danyw/PAR-Spectrometer/assets/Spectral response.xlsx

Sheet: Sheet1
 |  |  |  |  | SPECTRAL RESPONSE CORRECTION |  |  |  | CALIBRATION COEFFICIENTS
Wavelength [nm] | Typical | Actual | Normalized
340 | 35511300000000000 | 44540600000000000 | 646.57 |  |  |  | A0+B1_*pix+B2_*POWER(pix,2)+B3_*POWER(pix,3)+B4_*POWER(pix,4)+B5_*POWER(pix,5)
400 | 64586500000000000 | 63759400000000000 | 979.09
450 | 59557700000000000 | 64968200000000000 | 1000.00 |  |  |  |  |  |  |  |  |  |  | Pix | Waw. | Semsitivity | Normalized | Factor | Pix | Waw. | Semsitivity | Normalized | Factor | Pix | Waw. | Semsitivity | Normalized | Factor | Pix | Waw. | Semsitivity | Normalized | Factor | Pix | W.length | Semsitivity | Normalized | Factor | Pix | Waw. | Semsitivity | Normalized | Factor
500 | 57024200000000000 | 47367700000000000 | 695.48 |  |  |  |  |  |  |  |  |  |  | 1 | 309.6 | 45106555351522816 | 656.36 | 1.52 | 51 | 440.8 | 64745797393076808 | 996.15 | 1.00 | 101 | 561.4 | 43116223665321216 | 621.93 | 1.61 | 151 | 667.9 | 32894626288700832 | 445.08 | 2.25 | 201 | 758.5 | 19696558853128176 | 216.73 | 4.61 | 251 | 833.8 | 8983587113354304 | 31.38 | 31.87
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
