danyw/PAR-Spectrometer/Core/Src/main.c

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
/* Includes ------------------------------------------------------------------*/
#include "main.h"
#include "adc.h"
#include "dma.h"
#include "opamp.h"
#include "spi.h"
#include "tim.h"
#include "usart.h"
#include "usb_otg.h"
#include "gpio.h"

/* USER CODE BEGIN Includes */
#include "../../lvgl/lvgl.h"
#include "../../lvgl/hal_stm_lvgl/tft/tft.h"
#include "../../lvgl/hal_stm_lvgl/touch/touchpad.h"
#include "../../lvgl/examples/lv_examples.h"
#include "ui.h"
#include "ui_helpers.h"
/* USER CODE END Includes */

/* USER CODE BEGIN PD */
# define ADC_BUF_L 288
/* USER CODE END PD */


/* USER CODE BEGIN PV */
uint16_t adc_buf[ADC_BUF_L];
uint16_t adc_base = 1290;
bool continous = 1;
bool averaging = 1;
//bool overexposed = false;
bool auto_exposure = true;
uint16_t avg_counter = 0;
uint16_t avg = 50;
uint32_t exptime = 5000;
uint16_t peak_pixel = 0;




float wavelength_converted[288];
/* USER CODE END PV */

void SystemClock_Config(void);
/* USER CODE BEGIN PFP */
void measure (void);

extern void refresh_chart(void);
extern void refresh_chart_y(void);
extern void wavelength_convert(void);
extern void exposure_time (uint32_t st_us);
extern void adc_convert_first(void);
extern void adc_convert_second(void);
extern void averaging_buf(void);
/* USER CODE END PFP */

/**
  * @brief  The application entry point.
  * @retval int
  */
int main(void)
{
  /* MCU Configuration--------------------------------------------------------*/

  /* Reset of all peripherals, Initializes the Flash interface and the Systick. */
  HAL_Init();

  /* Configure the system clock */
  SystemClock_Config();

  /* Initialize all configured peripherals */
  MX_GPIO_Init();
  MX_USART3_UART_Init();
  MX_DMA_Init();
  MX_USB_OTG_HS_USB_Init();
  MX_SPI1_Init();
  MX_TIM3_Init();
  MX_SPI3_Init();
  MX_TIM2_Init();
  MX_TIM4_Init();
  MX_TIM15_Init();
  MX_ADC1_Init();
  MX_OPAMP1_Init();
  /* USER CODE BEGIN 2 */
  lv_init();
	tft_init();
	touchpad_init();
	HAL_Delay(20);

	HAL_OPAMP_SelfCalibrate(&hopamp1);
	HAL_OPAMP_Start(&hopamp1);

	HAL_ADCEx_Calibration_Start(&hadc1, ADC_CALIB_OFFSET, ADC_SINGLE_ENDED);
	HAL_ADCEx_Calibration_Start(&hadc1, ADC_CALIB_OFFSET_LINEARITY, ADC_SINGLE_ENDED);

	wavelength_convert();


	ui_init();

	HAL_TIM_Base_Start_IT(&htim3);
	HAL_TIM_Base_Start(&htim15);



	HAL_Delay(20);
	HAL_ADC_Start_DMA(&hadc1, (uint32_t*)adc_buf, ADC_BUF_L);



  /* USER CODE END 2 */

  /* Infinite loop */
  /* USER CODE BEGIN WHILE */
  while (1)
  {
  	HAL_Delay(30);
		lv_task_handler();


		if ((HAL_GPIO_ReadPin(GPIOC, B5_Pin)) == 1){
  	    	HAL_Delay(500);
  	    	exposure_time(exptime);
  	    	measure();


		}

    /* USER CODE END WHILE */

    /* USER CODE BEGIN 3 */
  }
  /* USER CODE END 3 */
}

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
/* USER CODE BEGIN 4 */

void HAL_ADC_ConvHalfCpltCallback(ADC_HandleTypeDef *hadc){
	if (averaging == 0){
	adc_convert_first();
	}

}

void HAL_ADC_ConvCpltCallback(ADC_HandleTypeDef* hadc){

	HAL_TIM_OC_Stop(&htim4, TIM_CHANNEL_2);
	HAL_TIM_OC_Stop(&htim4, TIM_CHANNEL_4);
	__HAL_TIM_CLEAR_FLAG(&htim2,TIM_FLAG_CC2);

	if (continous == 0 && (averaging == 0 || avg_counter == avg-1)){
			HAL_TIM_PWM_Stop(&htim4, TIM_CHANNEL_1);
			HAL_TIM_PWM_Stop(&htim2, TIM_CHANNEL_1);
			HAL_TIM_PWM_Stop_IT(&htim2, TIM_CHANNEL_2);
	}

	if (averaging == 1){
		averaging_buf();
	}
	else {
		adc_convert_second();
		refresh_chart_y();
	}
}

void HAL_TIM_PWM_PulseFinishedCallback(TIM_HandleTypeDef *htim)
{


	if(htim->Instance == TIM2){
		if(htim->Channel == HAL_TIM_ACTIVE_CHANNEL_2){
			//	HAL_TIM_PWM_Stop(&htim4, TIM_CHANNEL_1);
						HAL_TIM_OC_Start(&htim4, TIM_CHANNEL_4);
						HAL_TIM_OC_Start(&htim4, TIM_CHANNEL_2);
				//	HAL_TIM_Base_Stop_IT(&htim2);
		}



				}

}


void HAL_TIM_PeriodElapsedCallback(TIM_HandleTypeDef *htim)
{
  /* Prevent unused argument(s) compilation warning */
  UNUSED(htim);

	if(htim->Instance == TIM3)
	{
		lv_tick_inc(5);      /*Tell LVGL that 5 milliseconds were elapsed*/

	}
}

  /* NOTE : This function should not be modified, when the callback is needed,
            the HAL_TIM_PeriodElapsedCallback could be implemented in the user file
   */


void measure (void){
		HAL_TIM_PWM_Init(&htim2);
		HAL_TIM_PWM_Init(&htim4);
		HAL_TIM_PWM_Start(&htim4, TIM_CHANNEL_1);
		HAL_TIM_PWM_Start(&htim2, TIM_CHANNEL_1);
		HAL_TIM_PWM_Start_IT(&htim2, TIM_CHANNEL_2);
}

/* USER CODE END 4 */
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
