danyw/PAR-Spectrometer/LVGL_mine.ioc

Mcu.UserName=STM32H7A3ZITxQ
PA0.Signal=S_TIM2_CH1_ETR
PA10.GPIO_Label=USB_FS_ID [ZX62RD-AB-5P8_ID]
PA10.Signal=USB_OTG_HS_ID
PA11.GPIO_Label=USB_FS_N [USBLC6-2SC6_IO_1]
PA11.Signal=USB_OTG_HS_DM
PA12.GPIO_Label=USB_FS_P [USBLC6-2SC6_IO_2]
PA12.Signal=USB_OTG_HS_DP
PA2.GPIO_Label=LCD_DC
PA2.Signal=GPIO_Output
PA3.GPIO_Label=LCD_RST
PA3.Signal=GPIO_Output
PA4.GPIO_Label=LCD_CS
PA4.Signal=GPIO_Output
PA5.GPIO_Label=LCD_SCK
PA5.Signal=SPI1_SCK
PA6.GPIO_Label=LCD_MISO
PA6.Signal=SPI1_MISO
PA7.GPIO_Label=LCD_MOSI
PA7.Signal=SPI1_MOSI
PA9.GPIO_Label=USB_FS_VBUS  [ZX62RD-AB-5P8_VBUS]
PA9.Signal=USB_OTG_HS_VBUS
PB0.Signal=OPAMP1_VINP
PB11.GPIO_Label=TOUCH_IRQ
PB11.Signal=GPIO_Input
PB14.GPIO_Label=LD3 (Red Led)
PB14.Signal=GPIO_Output
PB2.GPIO_Label=TOUCH_MOSI
PB2.Signal=SPI3_MOSI
PC10.GPIO_Label=TOUCH_SCK
PC10.Signal=SPI3_SCK
PC11.GPIO_Label=TOUCH_MISO
PC11.Signal=SPI3_MISO
PC13.GPIO_Label=B5
PC13.Signal=GPIO_Input
PC14-OSC32_IN.GPIO_Label=OSC32_IN
PC14-OSC32_IN.Signal=RCC_OSC32_IN
PC15-OSC32_OUT.GPIO_Label=OSC32_OUT
PC15-OSC32_OUT.Signal=RCC_OSC32_OUT
PC4.Signal=OPAMP1_VOUT
PD12.Signal=S_TIM4_CH1
PD13.Signal=S_TIM4_CH2
PD8.GPIO_Label=STLINK_RX
PD8.Signal=USART3_TX
PD9.GPIO_Label=STLINK_TX
PD9.Signal=USART3_RX
PE0.GPIO_Label=ST_SIGNAL
PE0.Signal=GPIO_Output
PE1.GPIO_Label=LD2 (Yellow Led)
PE1.Signal=GPIO_Output
PE5.Signal=S_TIM15_CH1
PF10.GPIO_Label=USB_FS_PWR_EN [STMPS2141STR_EN]
PF10.Signal=GPIO_Output
PF8.GPIO_Label=TOUCH_CS
PF8.Signal=GPIO_Output
PG7.GPIO_Label=USB_FS_OVCR  [STMPS2141STR_FAULT]
PG7.Signal=GPXTI7
PH0-OSC_IN.GPIO_Label=PH0-MCU
PH0-OSC_IN.Signal=RCC_OSC_IN
PH1-OSC_OUT.GPIO_Label=PH1-MCU
PH1-OSC_OUT.Signal=RCC_OSC_OUT
