danyw/PAR-Spectrometer/Core/Inc/main.h

#define intTime 100
#define lowBase 0.000375
#define LOWdelay 280*88
#define ARR_clk 280
#define ppulse 280*(6+intTime)
#define _Length ppulse+30480
#define test 1
#define B5_Pin GPIO_PIN_13
#define B5_GPIO_Port GPIOC
#define OSC32_IN_Pin GPIO_PIN_14
#define OSC32_IN_GPIO_Port GPIOC
#define OSC32_OUT_Pin GPIO_PIN_15
#define OSC32_OUT_GPIO_Port GPIOC
#define TOUCH_CS_Pin GPIO_PIN_8
#define TOUCH_CS_GPIO_Port GPIOF
#define USB_FS_PWR_EN_Pin GPIO_PIN_10
#define USB_FS_PWR_EN_GPIO_Port GPIOF
#define PH0_MCU_Pin GPIO_PIN_0
#define PH0_MCU_GPIO_Port GPIOH
#define PH1_MCU_Pin GPIO_PIN_1
#define PH1_MCU_GPIO_Port GPIOH
#define LCD_DC_Pin GPIO_PIN_2
#define LCD_DC_GPIO_Port GPIOA
#define LCD_RST_Pin GPIO_PIN_3
#define LCD_RST_GPIO_Port GPIOA
#define LCD_CS_Pin GPIO_PIN_4
#define LCD_CS_GPIO_Port GPIOA
#define LCD_SCK_Pin GPIO_PIN_5
#define LCD_SCK_GPIO_Port GPIOA
#define LCD_MISO_Pin GPIO_PIN_6
#define LCD_MISO_GPIO_Port GPIOA
#define LCD_MOSI_Pin GPIO_PIN_7
#define LCD_MOSI_GPIO_Port GPIOA
#define TOUCH_MOSI_Pin GPIO_PIN_2
#define TOUCH_MOSI_GPIO_Port GPIOB
#define TOUCH_IRQ_Pin GPIO_PIN_11
#define TOUCH_IRQ_GPIO_Port GPIOB
#define LD3_Pin GPIO_PIN_14
#define LD3_GPIO_Port GPIOB
#define STLINK_RX_Pin GPIO_PIN_8
#define STLINK_RX_GPIO_Port GPIOD
#define STLINK_TX_Pin GPIO_PIN_9
#define STLINK_TX_GPIO_Port GPIOD
#define USB_FS_OVCR_Pin GPIO_PIN_7
#define USB_FS_OVCR_GPIO_Port GPIOG
#define USB_FS_VBUS_Pin GPIO_PIN_9
#define USB_FS_VBUS_GPIO_Port GPIOA
#define USB_FS_ID_Pin GPIO_PIN_10
#define USB_FS_ID_GPIO_Port GPIOA
#define USB_FS_N_Pin GPIO_PIN_11
#define USB_FS_N_GPIO_Port GPIOA
#define USB_FS_P_Pin GPIO_PIN_12
#define USB_FS_P_GPIO_Port GPIOA
#define TOUCH_SCK_Pin GPIO_PIN_10
#define TOUCH_SCK_GPIO_Port GPIOC
#define TOUCH_MISO_Pin GPIO_PIN_11
#define TOUCH_MISO_GPIO_Port GPIOC
#define ST_SIGNAL_Pin GPIO_PIN_0
#define ST_SIGNAL_GPIO_Port GPIOE
#define LD2_Pin GPIO_PIN_1
#define LD2_GPIO_Port GPIOE
