danyw/PAR-Spectrometer/Core/Inc/ui.h

// SquareLine LVGL GENERATED FILE
// EDITOR VERSION: SquareLine Studio 1.1.1
// LVGL VERSION: 8.2.0
// PROJECT: SpectrometerDisplayV1

#ifndef _SPECTROMETERDISPLAYV1_UI_H
#define _SPECTROMETERDISPLAYV1_UI_H

#ifdef __cplusplus
extern "C" {
#endif

 #if __has_include("lvgl.h")
#include "lvgl.h"
#else
#include "../../lvgl/lvgl.h"
#endif

extern lv_obj_t * ui_HomeScreen;
extern lv_obj_t * ui_TitleLabel1;
extern lv_obj_t * ui_calibrationBar;
extern lv_obj_t * ui_calibrationLabel;
void ui_event_HomeStartButton(lv_event_t * e);
extern lv_obj_t * ui_HomeStartButton;
extern lv_obj_t * ui_StartLabel;
void ui_event_homeOptionsButton(lv_event_t * e);
extern lv_obj_t * ui_homeOptionsButton;
extern lv_obj_t * ui_OptionsLabel;
void ui_event_HomeScreen_HomeStartButton1(lv_event_t * e);
extern lv_obj_t * ui_HomeScreen_HomeStartButton1;
extern lv_obj_t * ui_StartLabel1;
extern lv_obj_t * ui_MeasurementsScreen;
extern lv_obj_t * ui_TitleLabel;
void ui_event_backButton3(lv_event_t * e);
extern lv_obj_t * ui_backButton3;
extern lv_obj_t * ui_backLabel5;
void ui_event_fullButton(lv_event_t * e);
extern lv_obj_t * ui_fullButton;
extern lv_obj_t * ui_fullLabel;
void ui_event_PARbutton(lv_event_t * e);
extern lv_obj_t * ui_PARbutton;
extern lv_obj_t * ui_PARlabel;
extern lv_obj_t * ui_userButton;
extern lv_obj_t * ui_UserLabel;
void ui_event_MeasurementsAveragingSlider(lv_event_t * e);
extern lv_obj_t * ui_MeasurementsAveragingSlider;
void ui_event_Measurements_Button4(lv_event_t * e);
extern lv_obj_t * ui_Measurements_Button4;
extern lv_obj_t * ui_MeasurementsAveragingLabel;
void ui_event_gainSwitch(lv_event_t * e);
extern lv_obj_t * ui_gainSwitch;
void ui_event_autoexposureSwitch(lv_event_t * e);
extern lv_obj_t * ui_autoexposureSwitch;
extern lv_obj_t * ui_GainLabel;
extern lv_obj_t * ui_autoesxposureLabel;
extern lv_obj_t * ui_averaginglabel;
extern lv_obj_t * ui_ChartFullScreen;
void ui_event_ChartFullMeasureButton(lv_event_t * e);
extern lv_obj_t * ui_ChartFullMeasureButton;
extern lv_obj_t * ui_ChartFullMeasureLabel;
extern lv_obj_t * ui_ChartFullChart;
void ui_event_backButton2(lv_event_t * e);
extern lv_obj_t * ui_backButton2;
extern lv_obj_t * ui_backLabel4;
void ui_event_ChartFullDropdown(lv_event_t * e);
extern lv_obj_t * ui_ChartFullDropdown;
extern lv_obj_t * ui_exposuretimLabel;
extern lv_obj_t * ui_CCTlabel;
extern lv_obj_t * ui_CRIlabel;
extern lv_obj_t * ui_CIE1931label;
extern lv_obj_t * ui_CCTeditLabel;
extern lv_obj_t * ui_CRIeditLabel;
extern lv_obj_t * ui_CIE1931editLabel;
extern lv_obj_t * ui_usLabel1;
void ui_event_FButton(lv_event_t * e);
extern lv_obj_t * ui_FButton;
extern lv_obj_t * ui_FLabel;
void ui_event_exposureTimSlider3(lv_event_t * e);
extern lv_obj_t * ui_exposureTimSlider3;
extern lv_obj_t * ui_OptionsScreen;
void ui_event_backButton1(lv_event_t * e);
extern lv_obj_t * ui_backButton1;
extern lv_obj_t * ui_backLabel3;
void ui_event_StartadcButton(lv_event_t * e);
extern lv_obj_t * ui_StartadcButton;
void ui_event_optionsStartadcLabel(lv_event_t * e);
extern lv_obj_t * ui_optionsStartadcLabel;
extern lv_obj_t * ui_optionRoller;
void ui_event_OptionsScreen_Measurements_Slide(lv_event_t * e);
extern lv_obj_t * ui_OptionsScreen_Measurements_Slide;
extern lv_obj_t * ui_ChartparScreen;
void ui_event_exposureTimSlider(lv_event_t * e);
extern lv_obj_t * ui_exposureTimSlider;
void ui_event_ChartparMeasureButton(lv_event_t * e);
extern lv_obj_t * ui_ChartparMeasureButton;
extern lv_obj_t * ui_measureLabel;
extern lv_obj_t * ui_ChartparChart;
void ui_event_backButton(lv_event_t * e);
extern lv_obj_t * ui_backButton;
extern lv_obj_t * ui_backLabel2;
void ui_event_menuDropdown(lv_event_t * e);
extern lv_obj_t * ui_menuDropdown;
extern lv_obj_t * ui_exposuretimLabel1;
extern lv_obj_t * ui_CCTlabel1;
extern lv_obj_t * ui_CRIlabel1;
extern lv_obj_t * ui_CIE1931Label;
extern lv_obj_t * ui_CCTeditLabel1;
extern lv_obj_t * ui_CRIeditLabel1;
extern lv_obj_t * ui_CIE1931editLabel1;
extern lv_obj_t * ui_PPFDlabel;
extern lv_obj_t * ui_PPFDeditLabel;
extern lv_obj_t * ui_usLabel;
void ui_event_Fbutton(lv_event_t * e);
extern lv_obj_t * ui_Fbutton;
void ui_event_Flabel(lv_event_t * e);
extern lv_obj_t * ui_Flabel;
extern lv_obj_t * ui_Chartfullfull;
void ui_event_exposureTimSlider1(lv_event_t * e);
extern lv_obj_t * ui_exposureTimSlider1;
void ui_event_Measurements_Button7(lv_event_t * e);
extern lv_obj_t * ui_Measurements_Button7;
extern lv_obj_t * ui_Measurements_Label12;
extern lv_obj_t * ui_ChartfullfullChart;
void ui_event_backbutton(lv_event_t * e);
extern lv_obj_t * ui_backbutton;
extern lv_obj_t * ui_backLabel;
void ui_event_menuDropdown1(lv_event_t * e);
extern lv_obj_t * ui_menuDropdown1;
extern lv_obj_t * ui_usLabel2;
extern lv_obj_t * ui_Chartparfull;
void ui_event_exposureTimSlider2(lv_event_t * e);
extern lv_obj_t * ui_exposureTimSlider2;
void ui_event_Measurements_Button10(lv_event_t * e);
extern lv_obj_t * ui_Measurements_Button10;
void ui_event_Measurements_Label17(lv_event_t * e);
extern lv_obj_t * ui_Measurements_Label17;
extern lv_obj_t * ui_ChartParfullChart;
void ui_event_backbutton1(lv_event_t * e);
extern lv_obj_t * ui_backbutton1;
extern lv_obj_t * ui_backLabel1;
void ui_event_ChartFull_Dropdown4(lv_event_t * e);
extern lv_obj_t * ui_ChartFull_Dropdown4;
extern lv_obj_t * ui_usLabel3;

void faveraging(lv_event_t * e);
void fgaincheck(lv_event_t * e);
void fgainunchecked(lv_event_t * e);
void fautoexposureon(lv_event_t * e);
void fautoexposureunchecked(lv_event_t * e);
void fmeasure(lv_event_t * e);
void menuchanged(lv_event_t * e);
void fexposurechange(lv_event_t * e);
void fmeasure(lv_event_t * e);
void fexposurechange(lv_event_t * e);
void fexposurechange(lv_event_t * e);
void fmeasure(lv_event_t * e);
void menuchanged(lv_event_t * e);
void fmeasure(lv_event_t * e);
void fexposurechange(lv_event_t * e);
void fmeasure(lv_event_t * e);
void menuchanged(lv_event_t * e);
void fexposurechange(lv_event_t * e);
void fmeasure(lv_event_t * e);
void fmeasure(lv_event_t * e);
void menuchanged(lv_event_t * e);





void ui_init(void);

#ifdef __cplusplus
} /*extern "C"*/
#endif

#endif
