danyw/PAR-Spectrometer/(commit log)

2022-10-31 cosmetic changes to the chart, fix hard fault
    div/0 ->minor tick=0
    [LVGL_mine.ioc, ui.c]
2022-11-05 wavelength correction before main, refresh chart
    [main.c, main.h, spectrometer.c, ui.c]
2022-11-05 Use sensitivity data for correcting adc_buff.
    [main.c, spectrometer.c, ui.c]
2022-11-06 Initialise wavelength correction. Update y values when refreshing.
    [main.c, ui.c]
2022-11-08 Convert spectral response, take single measurements, half complete adc,dont process far pixels
2022-11-09 add gain, add peak_wavelength function,PAR fix
    change wavelength_converted[288] to float.
    Need to add UI before it all works.
    [main.c, spectrometer.c, ui.c]
2024-06-16 add assets
    [Spectral response.xlsx]
